zrcni/home-irrigation/src/plant-irrigator/README.md

todo populate readme

Capacitive Soil Moisture Sensor v2.0 (black)

air 2900
water 1600
soil ?

not-wet soil 2300 (but not quite dry either)
wet soil 1700

good limit 2400-2500?

---

If system is updated to be more modular and flexible, each plant having ESP32, relay and valve, then 4 amp power source is required to power everything.

https://www.spelektroniikka.fi/p27935-dc-virtalahde-5v-4a-20w-21-55mm-fi.html

---

- add led to indicate active system?
