zrcni/home-irrigation/src/plant-irrigator/main/main.c

#include <stdio.h>
#include <string.h>
#include "freertos/FreeRTOS.h"
#include "freertos/task.h"
#include "nvs_flash.h"
#include "esp_log.h"
#include "esp_spiffs.h"
#include "cJSON.h"
#include "driver/gpio.h"
#include "esp_sleep.h"

#include "wifi_app.h"
#include "mqtt_app.h"
#include "plant.h"
#include "config_loader.h"

static const char *TAG = "main";

// GPIO 8 for ESP32-C3 Super Mini (Onboard LED). 
// Use GPIO 2 for ESP-WROOM-32.
#define BLINK_GPIO 8 

static app_config_t app_config;

void blink_init_task(void *pvParameter)
{
    gpio_reset_pin(BLINK_GPIO);
    gpio_set_direction(BLINK_GPIO, GPIO_MODE_OUTPUT);
    
    while (1) {
        gpio_set_level(BLINK_GPIO, 0); // LED ON (Active Low)
        vTaskDelay(pdMS_TO_TICKS(100));
        gpio_set_level(BLINK_GPIO, 1); // LED OFF
        vTaskDelay(pdMS_TO_TICKS(100));
    }
}

void blink_error_code(int blinks, int delay_ms)
{
    gpio_reset_pin(BLINK_GPIO);
    gpio_set_direction(BLINK_GPIO, GPIO_MODE_OUTPUT);
    
    while (1) {
        for (int i = 0; i < blinks; i++) {
            gpio_set_level(BLINK_GPIO, 0); // LED ON (Active Low)
            vTaskDelay(pdMS_TO_TICKS(delay_ms));
            gpio_set_level(BLINK_GPIO, 1); // LED OFF
            vTaskDelay(pdMS_TO_TICKS(delay_ms));
        }
        vTaskDelay(pdMS_TO_TICKS(1000)); // Pause between cycles
    }
}

static esp_err_t init_spiffs(void)
{
    ESP_LOGI(TAG, "Initializing SPIFFS");

    esp_vfs_spiffs_conf_t conf = {
        .base_path = "/spiffs",
        .partition_label = "storage",
        .max_files = 5,
        .format_if_mount_failed = true};

    esp_err_t ret = esp_vfs_spiffs_register(&conf);

    if (ret != ESP_OK)
    {
        if (ret == ESP_FAIL)
        {
            ESP_LOGE(TAG, "Failed to mount or format filesystem");
        }
        else if (ret == ESP_ERR_NOT_FOUND)
        {
            ESP_LOGE(TAG, "Failed to find SPIFFS partition");
        }
        else
        {
            ESP_LOGE(TAG, "Failed to initialize SPIFFS (%s)", esp_err_to_name(ret));
        }
        return ret;
    }

    size_t total = 0, used = 0;
    ret = esp_spiffs_info(conf.partition_label, &total, &used);
    if (ret != ESP_OK)
    {
        ESP_LOGE(TAG, "Failed to get SPIFFS partition information (%s)", esp_err_to_name(ret));
    }
    else
    {
        ESP_LOGI(TAG, "Partition size: total: %d, used: %d", total, used);
    }
    return ESP_OK;
}

void run_irrigation_cycle(adc_oneshot_unit_handle_t adc_handle)
{
    ESP_LOGI(TAG, "Starting irrigation cycle...");
    
    for (int i = 0; i < app_config.num_plants; i++)
    {
        plant_process(&app_config.plants[i], adc_handle, app_config.mqtt.topic, app_config.mqtt.device_id, app_config.mqtt.client_id);
        vTaskDelay(pdMS_TO_TICKS(1000)); // Small delay between plants
    }
    
    ESP_LOGI(TAG, "Irrigation cycle completed.");
}

void app_main(void)
{
    // Start Initialization Blink
    TaskHandle_t blink_task_handle = NULL;
    xTaskCreate(blink_init_task, "blink_init", 2048, NULL, 5, &blink_task_handle);

    // Initialize NVS
    esp_err_t ret = nvs_flash_init();
    if (ret == ESP_ERR_NVS_NO_FREE_PAGES || ret == ESP_ERR_NVS_NEW_VERSION_FOUND)
    {
        ESP_ERROR_CHECK(nvs_flash_erase());
        ret = nvs_flash_init();
    }
    ESP_ERROR_CHECK(ret);

    // Initialize SPIFFS
    ESP_ERROR_CHECK(init_spiffs());

    // Load Config
    if (!config_load(&app_config))
    {
        ESP_LOGE(TAG, "Failed to load configuration. Halting.");
        while (1)
        {
            vTaskDelay(pdMS_TO_TICKS(1000));
        }
    }

    // Start Services
    if (!wifi_app_start(app_config.wifi.ssid, app_config.wifi.password)) {
        if (blink_task_handle != NULL) vTaskDelete(blink_task_handle);
        ESP_LOGE(TAG, "WiFi Connection Failed. Halting.");
        blink_error_code(1, 1000); // Slow blink (1 blink per cycle, long delay)
    }

    if (!mqtt_app_start(&app_config.mqtt)) {
        if (blink_task_handle != NULL) vTaskDelete(blink_task_handle);
        ESP_LOGE(TAG, "MQTT Connection Failed. Halting.");
        blink_error_code(2, 200); // Fast double blink
    }

    // Initialize Plant System
    adc_oneshot_unit_handle_t adc_handle;
    plant_system_init(&adc_handle);

    // Initialize Plants
    for (int i = 0; i < app_config.num_plants; i++)
    {
        plant_gpio_init(&app_config.plants[i], adc_handle);
    }

    ESP_LOGI(TAG, "System initialized. Starting loop...");
    mqtt_app_publish_debug("System Initialized");

    // Stop Initialization Blink
    if (blink_task_handle != NULL) {
        vTaskDelete(blink_task_handle);
        gpio_set_level(BLINK_GPIO, 1); // Ensure LED is OFF
    }

    // Publish Initialization Message
    char payload[256];
    snprintf(payload, sizeof(payload),
        "{\"event\":\"system_initialized\",\"device_id\":\"%s\",\"client_id\":\"%s\"}",
        app_config.mqtt.device_id, app_config.mqtt.client_id);
    mqtt_app_publish(app_config.mqtt.topic, payload);

    if (app_config.deep_sleep_enabled) {
        run_irrigation_cycle(adc_handle);

        mqtt_app_publish_debug("Processing done. Entering deep sleep...");

        ESP_LOGI(TAG, "Waiting for MQTT messages to be sent...");
        if (mqtt_app_wait_all_published(10000)) {
            ESP_LOGI(TAG, "All MQTT messages published.");
        } else {
            ESP_LOGW(TAG, "Timeout waiting for MQTT messages to be published.");
        }

        ESP_LOGI(TAG, "Entering deep sleep for %d ms", app_config.sleep_duration_ms);
        esp_sleep_enable_timer_wakeup(app_config.sleep_duration_ms * 1000ULL);
        esp_deep_sleep_start();
    } else {
        while (1) {
            run_irrigation_cycle(adc_handle);
            
            mqtt_app_publish_debug("Processing done. Waiting for next cycle...");
            
            ESP_LOGI(TAG, "Waiting for %d ms", app_config.sleep_duration_ms);
            vTaskDelay(pdMS_TO_TICKS(app_config.sleep_duration_ms));
        }
    }
}
