zrcni/home-irrigation/src/plant-irrigator/main/plant.c

#include "plant.h"
#include "mqtt_app.h"
#include "esp_log.h"
#include "freertos/FreeRTOS.h"
#include "freertos/task.h"
#include <stdio.h>
#include "sdkconfig.h"

static const char *TAG = "plant";

// Relay is Active Low
#define VALVE_OPEN_LEVEL 0
#define VALVE_CLOSED_LEVEL 1

void plant_system_init(adc_oneshot_unit_handle_t *adc_handle)
{
    adc_oneshot_unit_init_cfg_t init_config1 = {
        .unit_id = ADC_UNIT_1,
    };
    ESP_ERROR_CHECK(adc_oneshot_new_unit(&init_config1, adc_handle));
}

void plant_gpio_init(const plant_config_t* plant, adc_oneshot_unit_handle_t adc_handle)
{
    // Init Sensor Power Pin
    gpio_reset_pin(plant->sensor_power_pin);
    gpio_set_direction(plant->sensor_power_pin, GPIO_MODE_OUTPUT);
    gpio_set_level(plant->sensor_power_pin, 0);
    ESP_LOGI(TAG, "Init: Set sensor power pin %d to 0", plant->sensor_power_pin);

    // Init Valve GPIO Pin
    gpio_reset_pin(plant->valve_gpio_pin);
    gpio_set_direction(plant->valve_gpio_pin, GPIO_MODE_OUTPUT);
    gpio_set_level(plant->valve_gpio_pin, VALVE_CLOSED_LEVEL);
    ESP_LOGI(TAG, "Init: Set valve pin %d to %d (OFF)", plant->valve_gpio_pin, VALVE_CLOSED_LEVEL);

    // Init ADC Channel
    adc_oneshot_chan_cfg_t config = {
        .bitwidth = ADC_BITWIDTH_DEFAULT,
        .atten = ADC_ATTEN_DB_12,
    };
    ESP_ERROR_CHECK(adc_oneshot_config_channel(adc_handle, plant->sensor_adc_channel, &config));
}

void plant_process(const plant_config_t* plant, adc_oneshot_unit_handle_t adc_handle, const char* mqtt_topic, const char* device_id, const char* client_id)
{
    // 1. Turn on Sensor
    gpio_set_level(plant->sensor_power_pin, 1);
    ESP_LOGI(TAG, "Plant %s: Set sensor power pin %d to 1", plant->plant_id, plant->sensor_power_pin);
    vTaskDelay(pdMS_TO_TICKS(100));

    // 2. Read Sensor
    int adc_raw;
    ESP_ERROR_CHECK(adc_oneshot_read(adc_handle, plant->sensor_adc_channel, &adc_raw));
    ESP_LOGI(TAG, "Plant %s: Moisture %d", plant->plant_id, adc_raw);

    // 3. Turn off Sensor
    gpio_set_level(plant->sensor_power_pin, 0);
    ESP_LOGI(TAG, "Plant %s: Set sensor power pin %d to 0", plant->plant_id, plant->sensor_power_pin);

    // 4. Publish Sensor Data
    char payload[256];
    
    snprintf(payload, sizeof(payload), 
        "{\"moisture\":%d,\"water_duration\":%d,\"device_id\":\"%s\",\"client_id\":\"%s\",\"plant_id\":\"%s\",\"plant_name\":\"%s\"}",
        adc_raw, 0, device_id, client_id, plant->plant_id, plant->plant_name ? plant->plant_name : "");
    
    mqtt_app_publish(mqtt_topic, payload);

    // 5. Check Threshold
    char debug_msg[128];
    if (adc_raw == 0 || adc_raw > 3800) {
        ESP_LOGW(TAG, "Plant %s: Sensor reading is %d (Invalid). Skipping check.", plant->plant_id, adc_raw);
        snprintf(debug_msg, sizeof(debug_msg), "Plant %s: Invalid sensor reading %d", plant->plant_id, adc_raw);
        mqtt_app_publish_debug(debug_msg);
    } else if (adc_raw > plant->moisture_dry_threshold) {
        ESP_LOGI(TAG, "Plant %s is DRY. Watering...", plant->plant_id);
        snprintf(debug_msg, sizeof(debug_msg), "Plant %s: DRY (%d > %d). Watering...", plant->plant_id, adc_raw, plant->moisture_dry_threshold);
        mqtt_app_publish_debug(debug_msg);
        
        // Open Valve
        gpio_set_level(plant->valve_gpio_pin, VALVE_OPEN_LEVEL);
        ESP_LOGI(TAG, "Plant %s: Set valve pin %d to %d (OPEN)", plant->plant_id, plant->valve_gpio_pin, VALVE_OPEN_LEVEL);
        vTaskDelay(pdMS_TO_TICKS(plant->release_duration_ms));
        gpio_set_level(plant->valve_gpio_pin, VALVE_CLOSED_LEVEL);
        ESP_LOGI(TAG, "Plant %s: Set valve pin %d to %d (CLOSE)", plant->plant_id, plant->valve_gpio_pin, VALVE_CLOSED_LEVEL);

        snprintf(debug_msg, sizeof(debug_msg), "Plant %s: Watering Complete", plant->plant_id);
        mqtt_app_publish_debug(debug_msg);

        // Publish Irrigation Event
        snprintf(payload, sizeof(payload), 
            "{\"moisture\":%d,\"water_duration\":%d,\"device_id\":\"%s\",\"client_id\":\"%s\",\"plant_id\":\"%s\",\"plant_name\":\"%s\"}",
            adc_raw, plant->release_duration_ms, device_id, client_id, plant->plant_id, plant->plant_name ? plant->plant_name : "");
        
        mqtt_app_publish(mqtt_topic, payload);
    } else {
        ESP_LOGI(TAG, "Plant %s is WET.", plant->plant_id);
        snprintf(debug_msg, sizeof(debug_msg), "Plant %s: WET (%d <= %d)", plant->plant_id, adc_raw, plant->moisture_dry_threshold);
        mqtt_app_publish_debug(debug_msg);
    }
}
