zrcni/home-irrigation/(commit log)

2022-10-17 moisture sensor works
2022-10-17 set up water pump via relay
2022-10-17 updated water pump on duration renamed moisture_sensor_test to moisture_sensor
2022-10-24 increased pump on duration
2022-11-01 split up moisture sensor v2 into multiple modules
2022-11-15 fixed check interval duration in moisture sensor v1
    [moisture_sensor.ino]
2022-11-15 made check interval duration update in moisture sensor v2
2025-12-29 add wiring diagram png
2025-12-29 update wiring diagrams
2025-12-31 update compile target to ESP32-C3 publish system_ready event remove timestamp from events
2025-12-31 wait for wifi and mqtt connection, and blink led if they fail
    [main.c, mqtt_app.c, wifi_app.c]
2025-12-31 blink led rapidly while initializing
2025-12-31 fix wifi connection issues
    [wifi_app.c]
2026-01-01 update pin 21 to 20 to avoid issues with tx
2026-01-02 update device to utilize deep sleep and home assistant to trigger watering when it receives updated moisture levels from device add "prevent deep sleep" button to home assistant
2026-01-02 add raspberry pi setup documentation
2026-01-02 add moisture sensor documentation
2026-01-02 disable led when in deep sleep
2026-01-02 revert led changes
